joel-colaso/2324_Projet1AB_-ingenuity-/General/CahierDesCharges.pdf

Functions engaged | Assessment criteria | Level of flexibility
PC1 | Communicating with the computer | Telecommunication | Bluetooth => Distance : …m
PC2 | Controlling our system with the computer | Telecommunication & Coding | Low response time
O1 | Optimizing | Weight | < … g
| | Size
| | Electricity consumption | < … W
M1 | Enable the user to locate the system | Altitude | ± … cm
T1 | Enables the system to fly | Motorization | … rps
T2 | Enables the system to move without user action throughout the entire movement | Predefined path
T3 | Enables the system to take a photo | Photography | Clean & sufficient quality (JPG ? PNG ?)
T4 | Allows user to view photo on computer | Telecommunication | One photo each second
