joel-colaso/2324_Projet1AB_-ingenuity-/Datasheets/Hardware/PCB/Ingenuity.kicad_pcb

## KiCad design Datasheets/Hardware/PCB/Ingenuity.kicad_pcb (2024-04-04, last stored version)

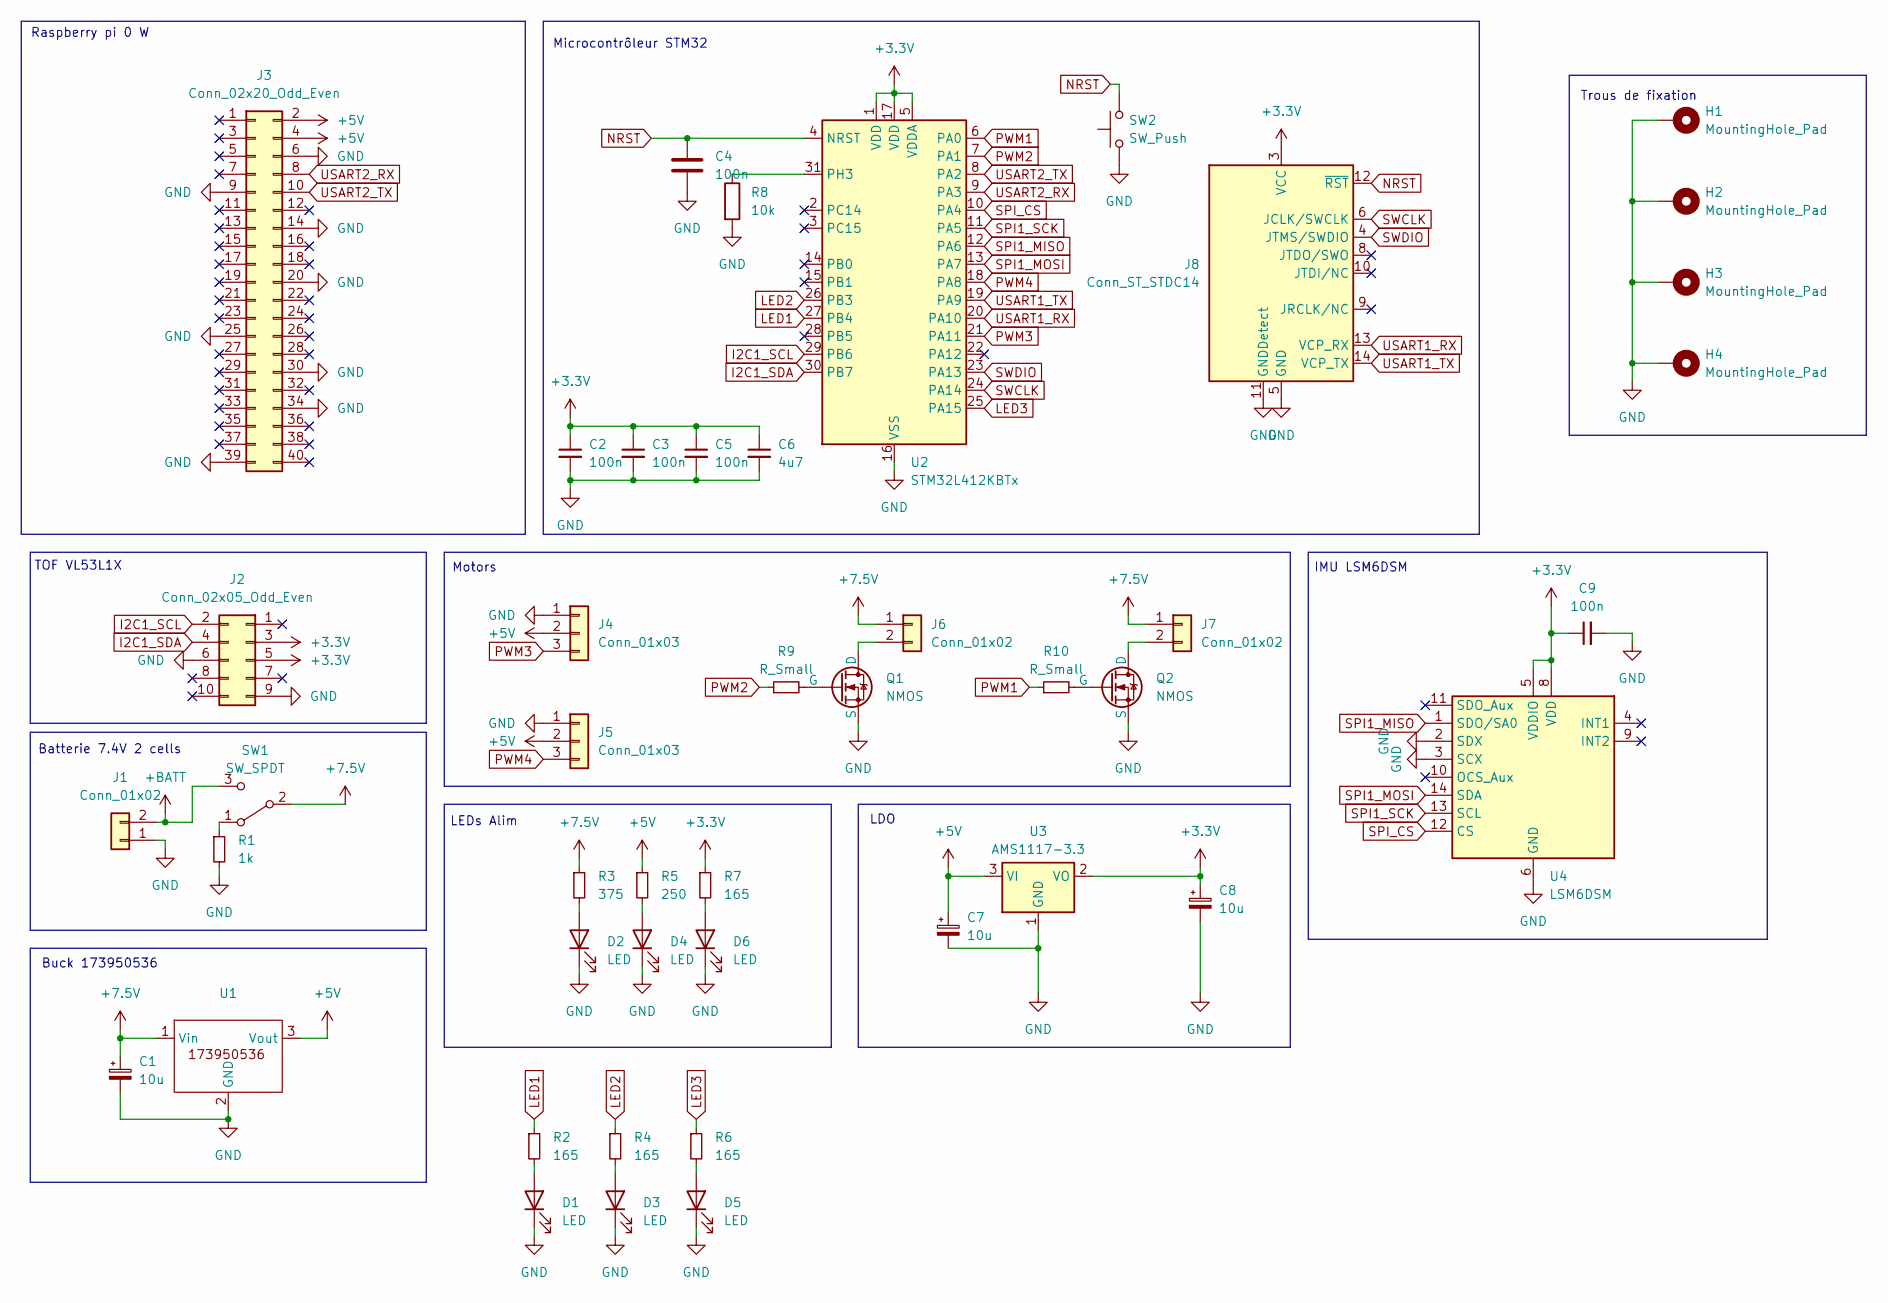
[picture p1: schematic Ingenuity.kicad_sch]

Parts:
C1, C7, C8: 10u; C_0603_1608Metric
C2, C3, C4, C5, C9: 100n; C_0402_1005Metric
C6: 4u7; C_0402_1005Metric
D1, D2, D3, D4, D5, D6: LED; LED_0603_1608Metric
H1, H2, H3, H4: MountingHole_Pad; MountingHole_2.7mm_M2.5_DIN965_Pad
J1, J6, J7: Conn_01x02; JST_XH_B2B-XH-A_1x02_P2.50mm_Vertical
J2: Conn_02x05_Odd_Even; PinHeader_2x05_P2.54mm_Vertical
J3: Conn_02x20_Odd_Even; PinHeader_2x20_P2.54mm_Vertical
J4, J5: Conn_01x03; JST_XH_B3B-XH-A_1x03_P2.50mm_Vertical
J8: Conn_ST_STDC14; PinHeader_2x07_P1.27mm_Vertical_SMD
Q1, Q2: NMOS; SOT-23
R1: 1k; R_0402_1005Metric
R2, R4, R6, R7: 165; R_0402_1005Metric
R3: 375; R_0402_1005Metric
R5: 250; R_0402_1005Metric
R8: 10k; R_0402_1005Metric
R9, R10: R_Small; R_0402_1005Metric
SW1: SW_SPDT; SW_472121010111; MPN 472121010111
SW2: SW_Push; SW_Push_1P1T_NO_6x6mm_H9.5mm
U1: Buck_17395xx36
U2: STM32L412KBTx; LQFP-32_7x7mm_P0.8mm; MPN STM32L412KBT6
U3: AMS1117-3.3; SOT-223-3_TabPin2
U4: LSM6DSM; LGA-14_3x2.5mm_P0.5mm_LayoutBorder3x4y

Connections:
+3.3V: C2.1, C3.1, C5.1, C6.1, C8.1, C9.1, J2.3, J2.5, J8.3 (VCC), R7.1, U2.1 (VDD), U2.5 (VDDA), U2.17 (VDD), U3.2 (VO), U4.5 (VDDIO), U4.8 (VDD)
+5V: C7.1, J3.2, J3.4, J4.2, J5.2, R5.1, U1.3 (Vout), U3.3 (VI)
+7.5V: C1.1, J6.1, J7.1, R3.1, SW1.2 (B), U1.1 (Vin)
+BATT: J1.2, SW1.3 (C)
GND: C1.2, C2.2, C3.2, C4.2, C5.2, C6.2, C7.2, C8.2, C9.2, D1.1 (K), D2.1 (K), D3.1 (K), D4.1 (K), D5.1 (K), D6.1 (K), H1.1, H2.1, H3.1, H4.1, J1.1, J2.6, J2.9, J3.6, J3.9, J3.14, J3.20, J3.25, J3.30, J3.34, J3.39, J4.1, J5.1, J8.5 (GND), J8.7 (GND), J8.11 (GNDDetect), Q1.3 (S), Q2.3 (S), R1.2, R8.2, SW2.1, U1.2 (GND), U2.16 (VSS), U2.32 (VSS), U3.1 (GND), U4.2 (SDX), U4.3 (SCX), U4.6 (GND), U4.7 (GND)
I2C1_SCL: J2.2, U2.29 (PB6)
I2C1_SDA: J2.4, U2.30 (PB7)
LED1: R2.1, U2.27 (PB4)
LED2: R4.1, U2.26 (PB3)
LED3: R6.1, U2.25 (PA15)
NRST: C4.1, J8.12 (~RST), SW2.2, U2.4 (NRST)
unnamed: D1.2 (A), R2.2
unnamed: D2.2 (A), R3.2
unnamed: D3.2 (A), R4.2
unnamed: D4.2 (A), R5.2
unnamed: D5.2 (A), R6.2
unnamed: D6.2 (A), R7.2
unnamed: J6.2, Q1.1 (D)
unnamed: J7.2, Q2.1 (D)
unnamed: Q1.2 (G), R9.2
unnamed: Q2.2 (G), R10.2
unnamed: R1.1, SW1.1 (A)
unnamed: R8.1, U2.31 (PH3)
PWM1: R10.1, U2.6 (PA0)
PWM2: R9.1, U2.7 (PA1)
PWM3: J4.3, U2.21 (PA11)
PWM4: J5.3, U2.18 (PA8)
SPI1_MISO: U2.12 (PA6), U4.1 (SDO/SA0)
SPI1_MOSI: U2.13 (PA7), U4.14 (SDA)
SPI1_SCK: U2.11 (PA5), U4.13 (SCL)
SPI_CS: U2.10 (PA4), U4.12 (CS)
SWCLK: J8.6 (JCLK/SWCLK), U2.24 (PA14)
SWDIO: J8.4 (JTMS/SWDIO), U2.23 (PA13)
USART1_RX: J8.13 (VCP_RX), U2.20 (PA10)
USART1_TX: J8.14 (VCP_TX), U2.19 (PA9)
USART2_RX: J3.8, U2.9 (PA3)
USART2_TX: J3.10, U2.8 (PA2)

Notes on the sheet:
Trous de fixation
Motors
LDO
Buck 173950536
Raspberry pi 0 W
IMU LSM6DSM
Batterie 7.4V 2 cells
LEDs Alim
Microcontrôleur STM32
TOF VL53L1X

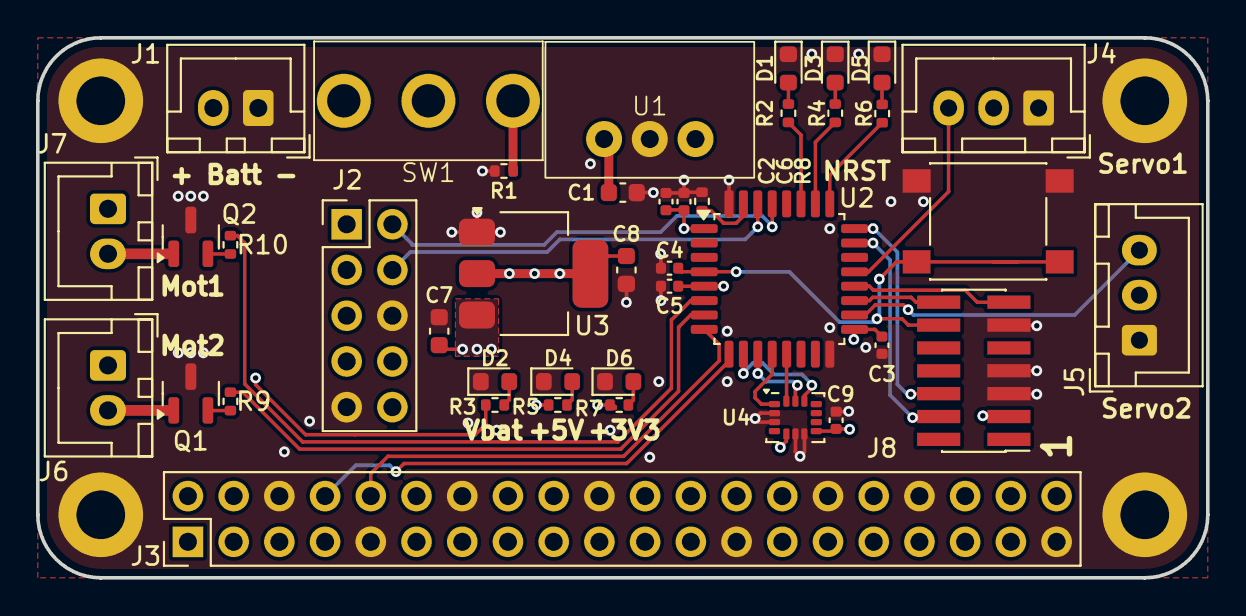
[picture p2: board Ingenuity.kicad_pcb from above]

Board: 4 copper layers, 65.0 x 30.0 mm, 45 parts (0 on the bottom side), 37 nets.
