joel-colaso/2324_Projet1AB_-ingenuity-/(commit log)

2024-03-18 update schematic
    [Ingenuity.kicad_pcb, Ingenuity.kicad_sch]
2024-03-31 update schematic, switch pins, change zones and routing
    [Ingenuity.kicad_pcb, Ingenuity.kicad_sch]
2024-04-03 add led, button
    [Ingenuity.kicad_pcb, Ingenuity.kicad_sch]
2024-04-04 finalize pcb
    [Ingenuity-B_Cu.gbr, Ingenuity-B_Mask.gbr, Ingenuity-B_Paste.gbr, Ingenuity-B_Silkscreen.gbr, Ingenuity-Edge_Cuts.gbr, Ingenuity-F_Cu.gbr, Ingenuity-F_Mask.gbr, Ingenuity-F_Paste.gbr]
